prrobinson81/VPO/Stop Jambs/Images/IMG_4729.jpeg

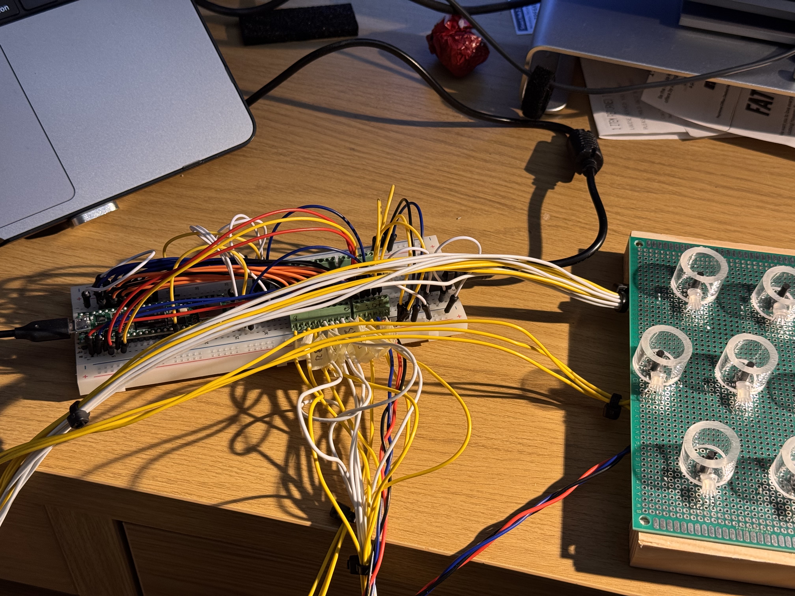
Stop Jambs/Images/IMG_4729.jpeg
