prrobinson81/VPO/Stop Jambs/Images/IMG_4732.jpeg

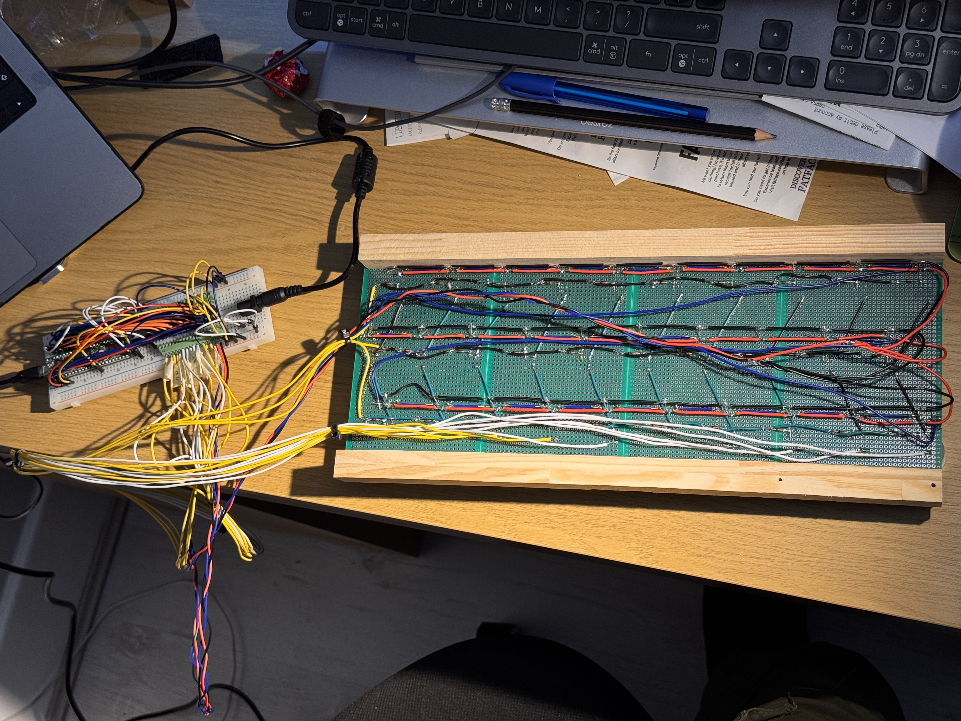
Stop Jambs/Images/IMG_4732.jpeg
