prrobinson81/VPO/Console/Woodwork.png

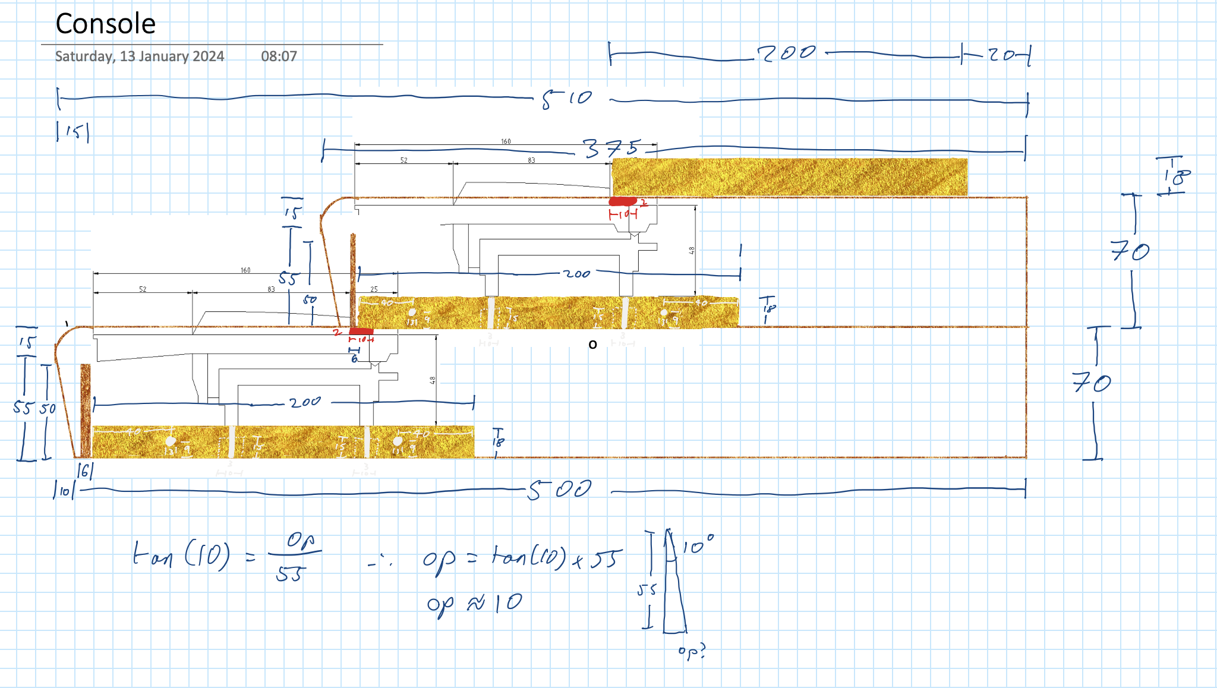
Console/Woodwork.png
