prrobinson81/VPO/Pedalboard/pedalboard_circuit_diagram.png

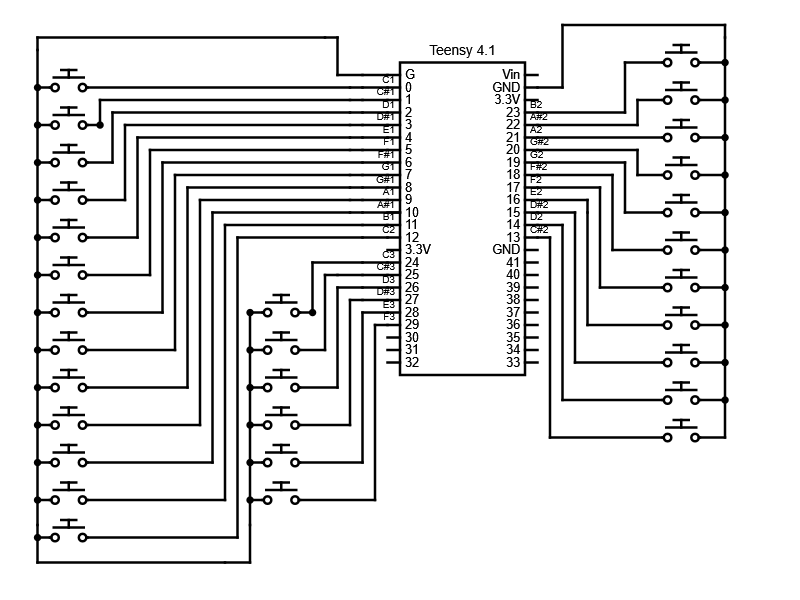
Pedalboard/pedalboard_circuit_diagram.png
