prrobinson81/VPO/Pistons/pistons_circuit_diagram.png

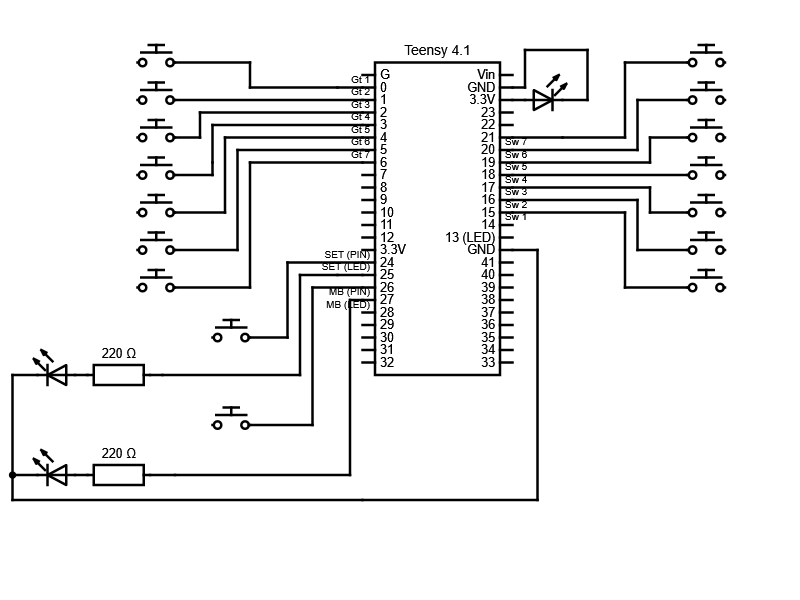
Pistons/pistons_circuit_diagram.png
