prrobinson81/VPO/Stop Jambs/Images/IMG_4728.jpeg

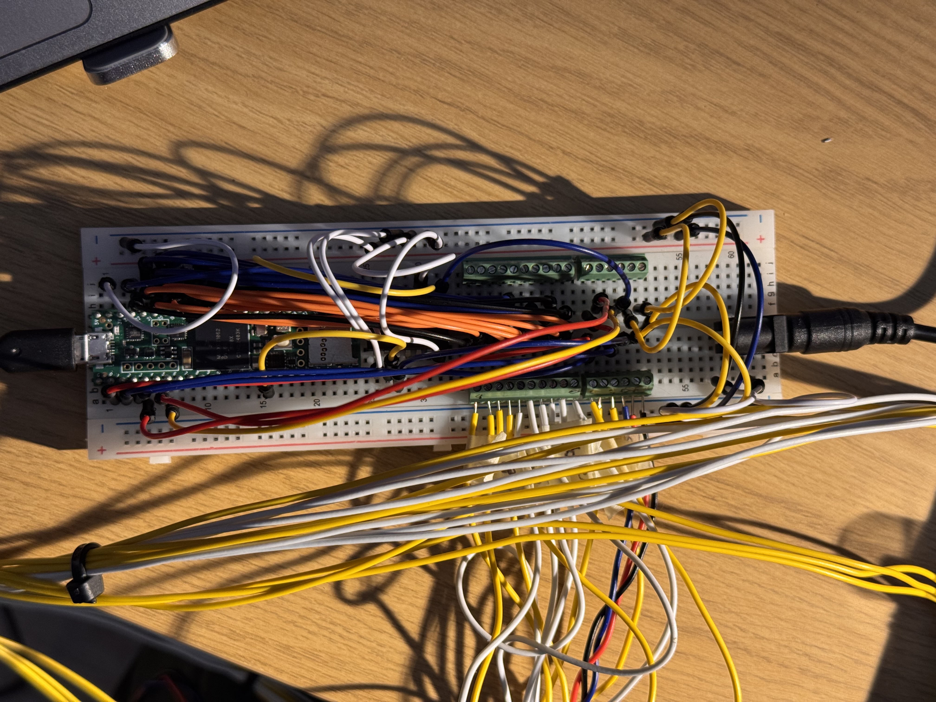
Stop Jambs/Images/IMG_4728.jpeg
