prrobinson81/VPO/Stop Jambs/Images/IMG_4730.jpeg

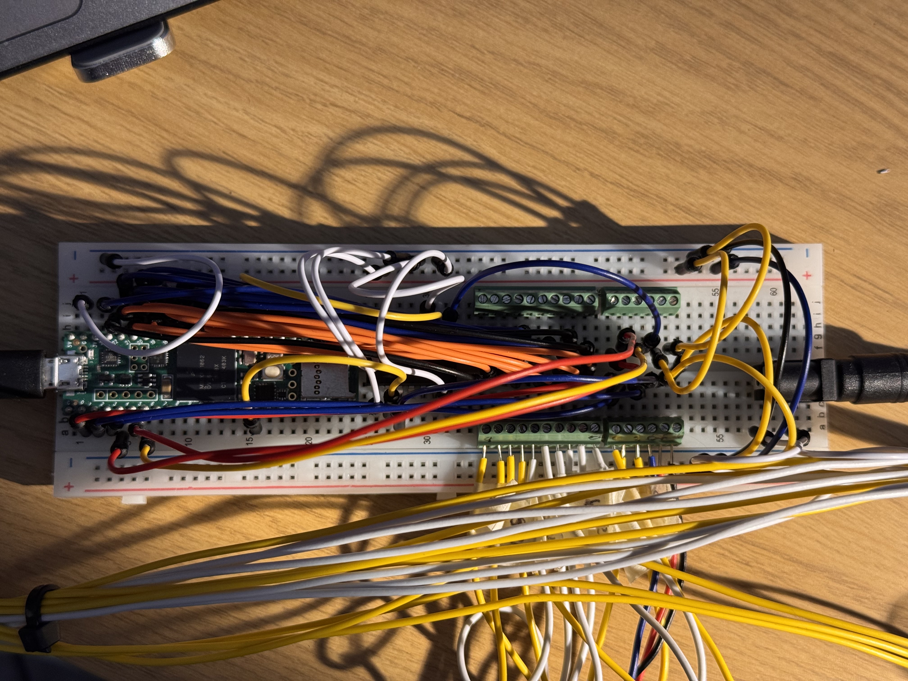
Stop Jambs/Images/IMG_4730.jpeg
