prrobinson81/VPO/Stop Jambs/Images/IMG_4733.jpeg

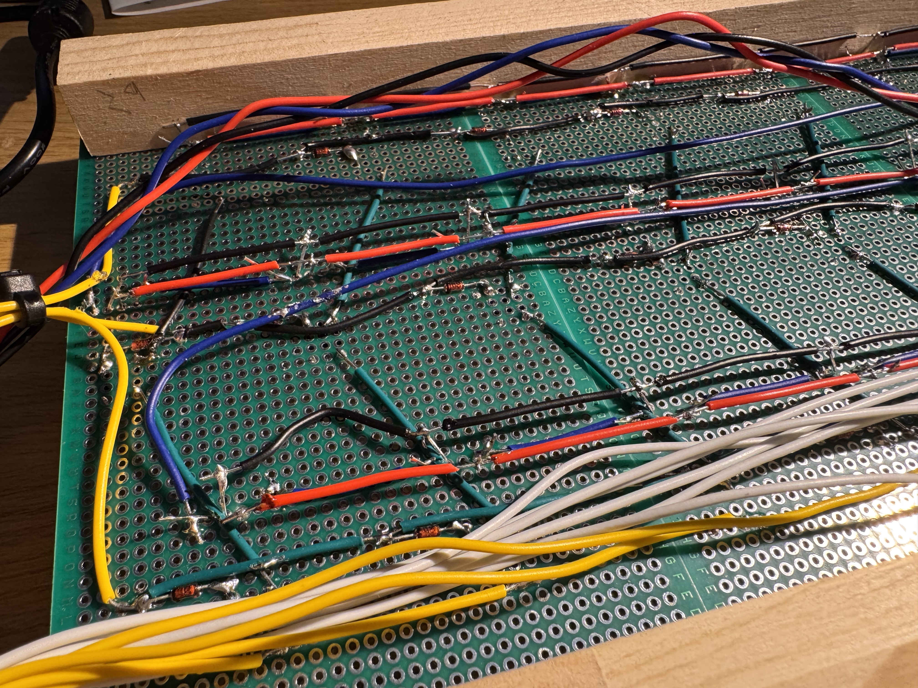
Stop Jambs/Images/IMG_4733.jpeg
