prrobinson81/VPO/Stop Jambs/Stream Deck Button Background/Choir-off.png

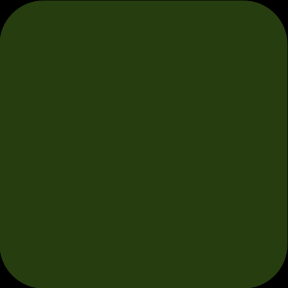
Stop Jambs/Stream Deck Button Background/Choir-off.png
