prrobinson81/VPO/Stop Jambs/Stream Deck Button Background/Great-off.png

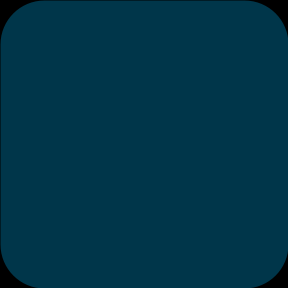
Stop Jambs/Stream Deck Button Background/Great-off.png
