prrobinson81/VPO/Stop Jambs/Stream Deck Button Background/Layout-selected.png

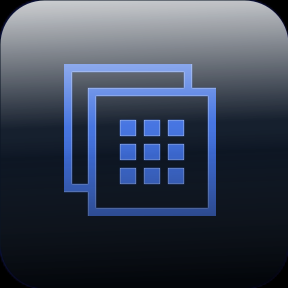
Stop Jambs/Stream Deck Button Background/Layout-selected.png
