prrobinson81/VPO/(commit log)

2024-08-01 Working version as burnt to the Teensy.
    [sketch_feb13a.ino]
2024-08-03 Piston circuit diagram
    PNG export, and original Circuit Diagram (https://www.circuit-diagram.org) file.
2024-08-03 Added console woodwork diagram.
    Roughly drawn diagram detailing the dimensions of the console woodwork, including all screw hole locations etc.
2024-08-03 Stop names and MIDI note values for different organs.
    [VPO Stops.xlsx]
2024-08-03 Update README.md to point to PJRC instead of Pi Hut for Teensy information.
2024-08-03 Moved sketch_pistons into own folder, as required by Arduino IDE.
2024-08-05 Added Pedalboard Arduino code.
2024-08-05 Added Pedalboard circuit diagram
2024-12-15 First pass at code for a keyboard-matrix based stop jamb.
    [name.c, sketch_switch_matrix.ino]
2024-12-28 Spelling corrections in the comments.
    [sketch_switch_matrix.ino]
2024-12-28 Added in Adafruit NeoPixel code. LED is on when switch is pressed, then off when released.
2025-10-28 Updated Teensy sketch to remove all the serial outputs and move over to pure MIDI functionality.
2025-10-28 Updated St Matthew .organ file with Choir to Swell coupler
2025-10-28 Updated St Matthew .organ file to exend compass of existing couplers to match extended keyboard compass.
2025-10-28 Updated St Matthew .organ file to stop Couplers being stored in Divisonals.
